DeadlyDaperling/Escher-s-Lizards-leather-belt-roller-emboss/lizzard1.stl

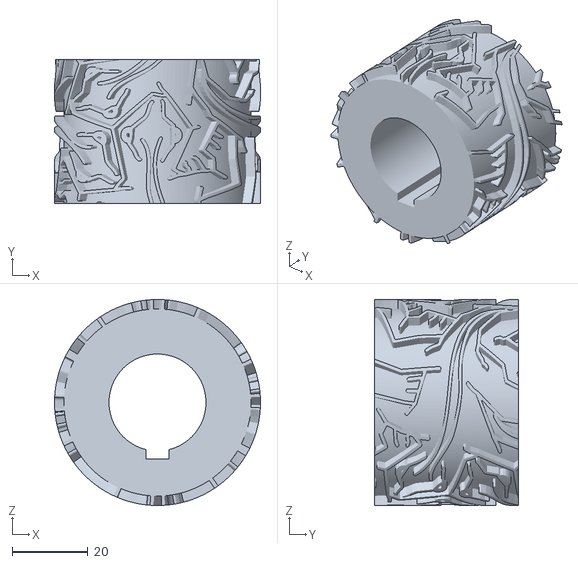
[picture p1: CAD file, 2026-11-03]
lizzard1.stl
54.5 x 38.1 x 54.5
