DeadlyDaperling/Escher-s-Lizards-leather-belt-roller-emboss/Lizzard2.stl

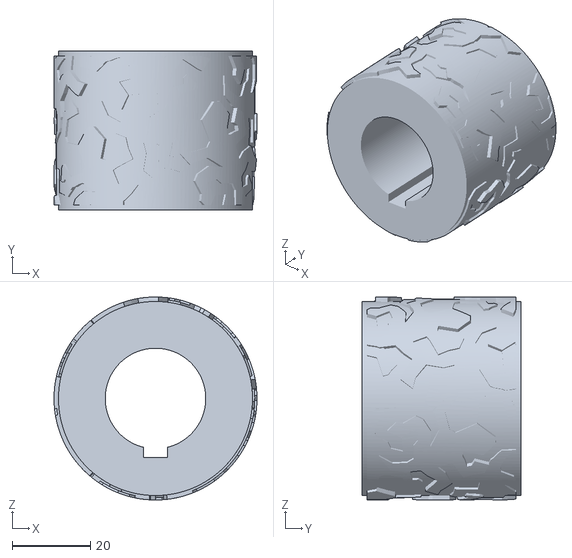
[picture p2: CAD file, 2026-10-29]
Lizzard2.stl
51.8 x 40.6 x 51.8
