DeadlyDaperling/Escher-s-Lizards-leather-belt-roller-emboss/(commit log)

2026-10-29 Add files via upload
    stl file for the roller emboss die the part
    Printer: Bambu Lab P1S
    Filament: PLA or PLA+
    Wall loops: 4
    Infill: 75%
    Infill pattern: grid
    Supports: none
    [Lizzard2.stl]
2026-10-29 Add files via upload
    Power point from Dylan Burns lecturer at UVM
